joshbohm37/Flip-segment-clock/README.md

# Flip Segment Clock
A desktop clock centered around electromechanical 7 segment flip displays.
