joshbohm37/Flip-segment-clock/docs/design-notes/landing.md

# Subsystems

[Control Logic](control-logic.md)

[Flip Segment Drivers](segment-driver.md)

[Power Notes](power-notes.md)

[Wifi Integration](wifi-integration.md)

[Lessons Learned](lessons-learned.md)
