joshbohm37/Flip-segment-clock/docs/subsystems/landing.md

# Subsystems

[Control Logic](control-logic.md)

[Firmware](firmware.md)

[Flip Segment Drivers](flip-segments.md)

[Power Architecture](power-architecture.md)

[Wifi](wifi.md)
