joshbohm37/Flip-segment-clock/hardware/segment-driver-a3909/pcb/zips/LIB_A3909GLNTR-T/A3909GLNTR-T/3D/A3909GLNTR-T.stp

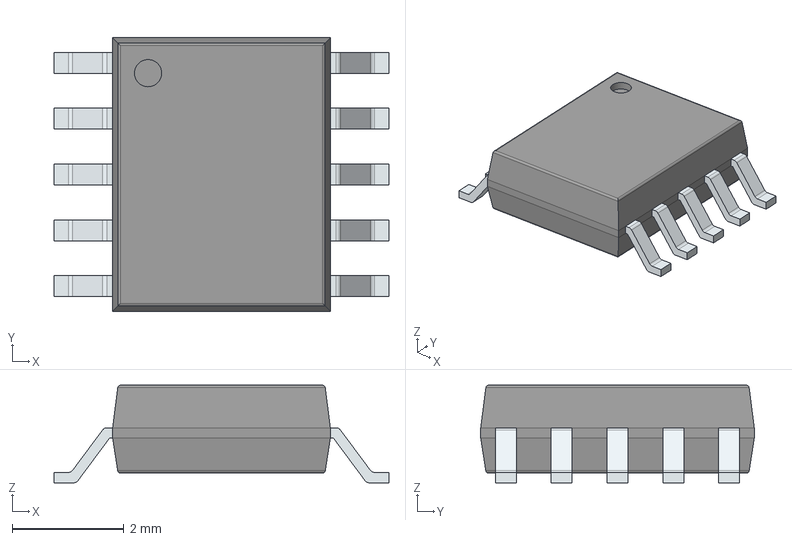
[picture p1: CAD file, 2025-11-30]
hardware/segment-driver-a3909/pcb/zips/LIB_A3909GLNTR-T/A3909GLNTR-T/3D/A3909GLNTR-T.stp
6.00 x 4.90 x 1.75 mm
PinsArrayLR
