joshbohm37/Flip-segment-clock/hardware/segment-driver-a3909/pcb/zips/LM73606RNPR/3D/LM73606RNPR.stp

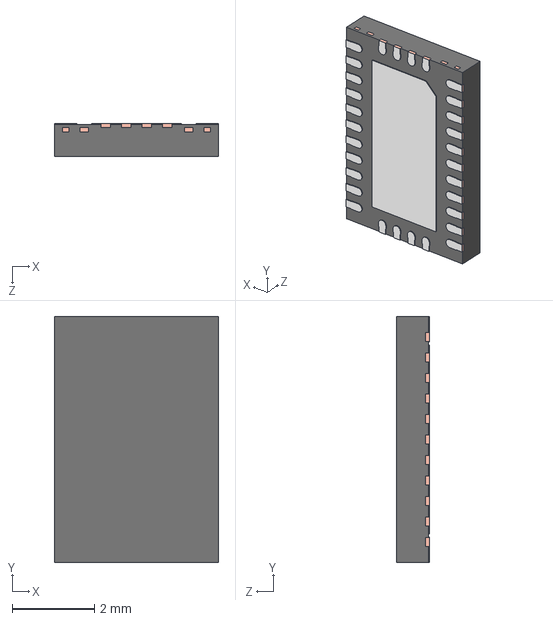
[picture p2: CAD file, 2025-11-30]
hardware/segment-driver-a3909/pcb/zips/LM73606RNPR/3D/LM73606RNPR.stp
4.00 x 6.00 x 0.8 mm
BODY-QFN
FRAME
