joshbohm37/Flip-segment-clock/(list of files, cad)

Other CAD files:
hardware/segment-driver-a3909/pcb/zips/LIB_A3909GLNTR-T/A3909GLNTR-T/Allegro/sop100p600x175-10n.psm
hardware/segment-driver-a3909/pcb/zips/LIB_A3909GLNTR-T/A3909GLNTR-T/DEHDL/a3909glntr_t/chips/chips.prt
hardware/segment-driver-a3909/pcb/zips/LM73606RNPR/Allegro/rnp0030a.psm
hardware/segment-driver-a3909/pcb/zips/LM73606RNPR/DEHDL/lm73606rnpr/chips/chips.prt
