joshbohm37/Flip-segment-clock/docs/changelog.md

#Changelog

**needs updating for all changes prior to 2026**

**1/1/26**: Refining design of the segment drivers

**1/3/26**: Implementation of per digit gating on A3909 clusters, allowing for isolation of power during time updates.
