joshbohm37/Flip-segment-clock/hardware/segment-driver-a3909/schematics/Sch.pdf

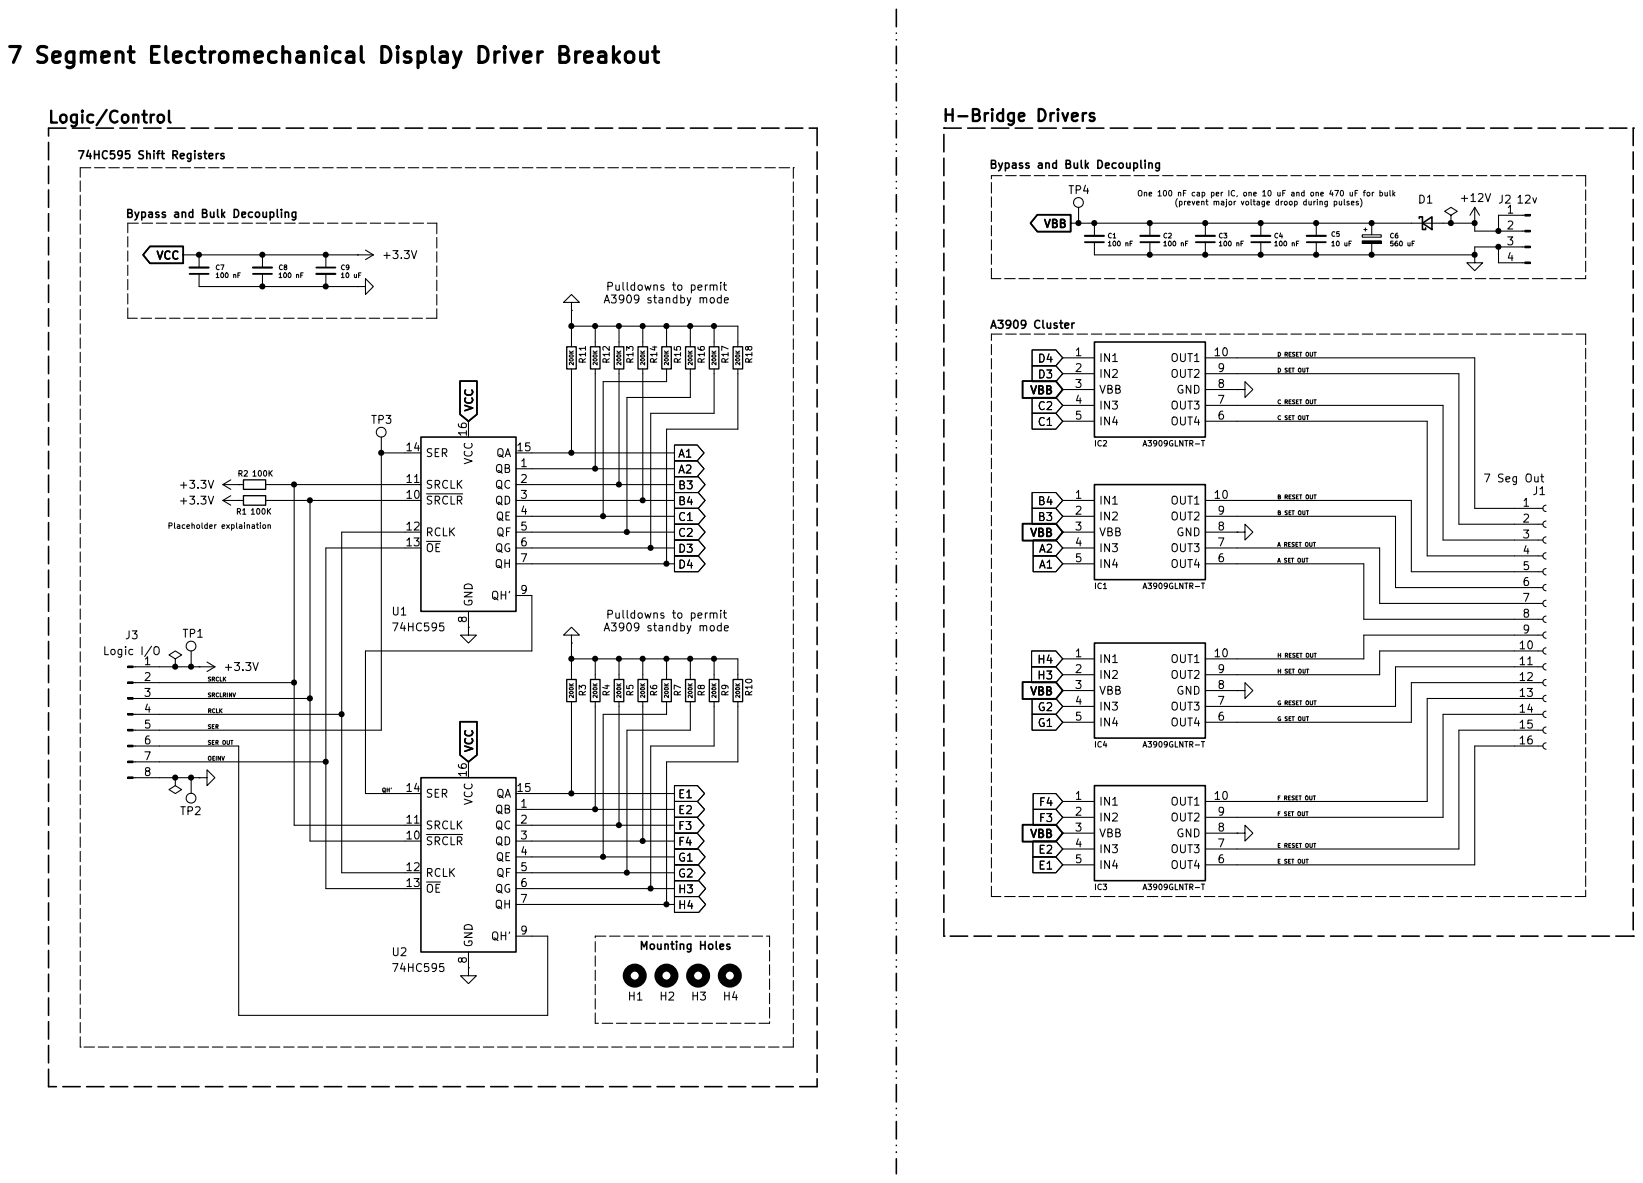
[picture p3: page 1]
