joshbohm37/Flip-segment-clock/(list of files, drawings)

Other design files:
hardware/segment-driver-a3909/pcb/zips/LIB_A3909GLNTR-T/A3909GLNTR-T/Altium/A3909GLNTR-T.SchLib
hardware/segment-driver-a3909/pcb/zips/LIB_A3909GLNTR-T/A3909GLNTR-T/Altium/SOP100P600X175-10N.PcbLib
