joshbohm37/Flip-segment-clock/hardware/main-board/pcb/flip-segment-clock_main-board/flip-segment-clock_main-board.kicad_pcb

## KiCad design hardware/main-board/pcb/flip-segment-clock_main-board/flip-segment-clock_main-board.kicad_pcb (2026-01-03)

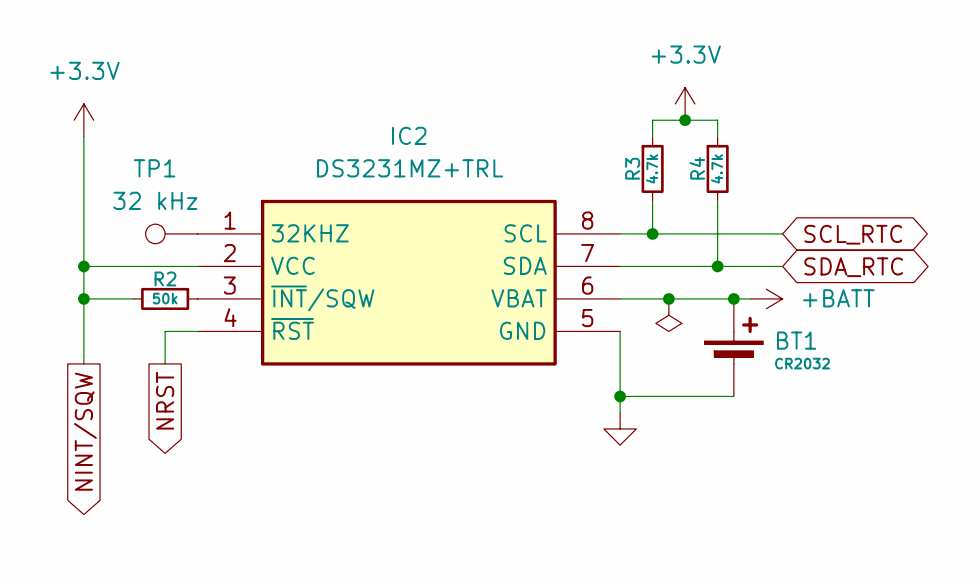
[picture p9: schematic DS3231.kicad_sch]

Parts:
BT1: CR2032; BatteryHolder_Keystone_1057_1x2032
IC2: DS3231MZ+TRL; SOIC127P600X175-8N; Mouser Part Number 700-DS3231MZ+TRL
R2: 50k; R_0402_1005Metric
R3, R4: 4.7k; R_0402_1005Metric
TP1: 32 kHz; TestPoint_Pad_D2.5mm

Connections:
+BATT: BT1.1 (+), IC2.6 (VBAT); also elsewhere on the board
GND: BT1.2 (-), IC2.5 (GND); also elsewhere on the board
NINT/SQW: IC2.2 (VCC), R2.2, R3.1, R4.1; also elsewhere on the board
NRST: IC2.4 (~RST)
unnamed: IC2.1 (32KHZ), TP1.1
unnamed: IC2.3 (~INT/SQW), R2.1
SCL_RTC: IC2.8 (SCL), R3.2
SDA_RTC: IC2.7 (SDA), R4.2

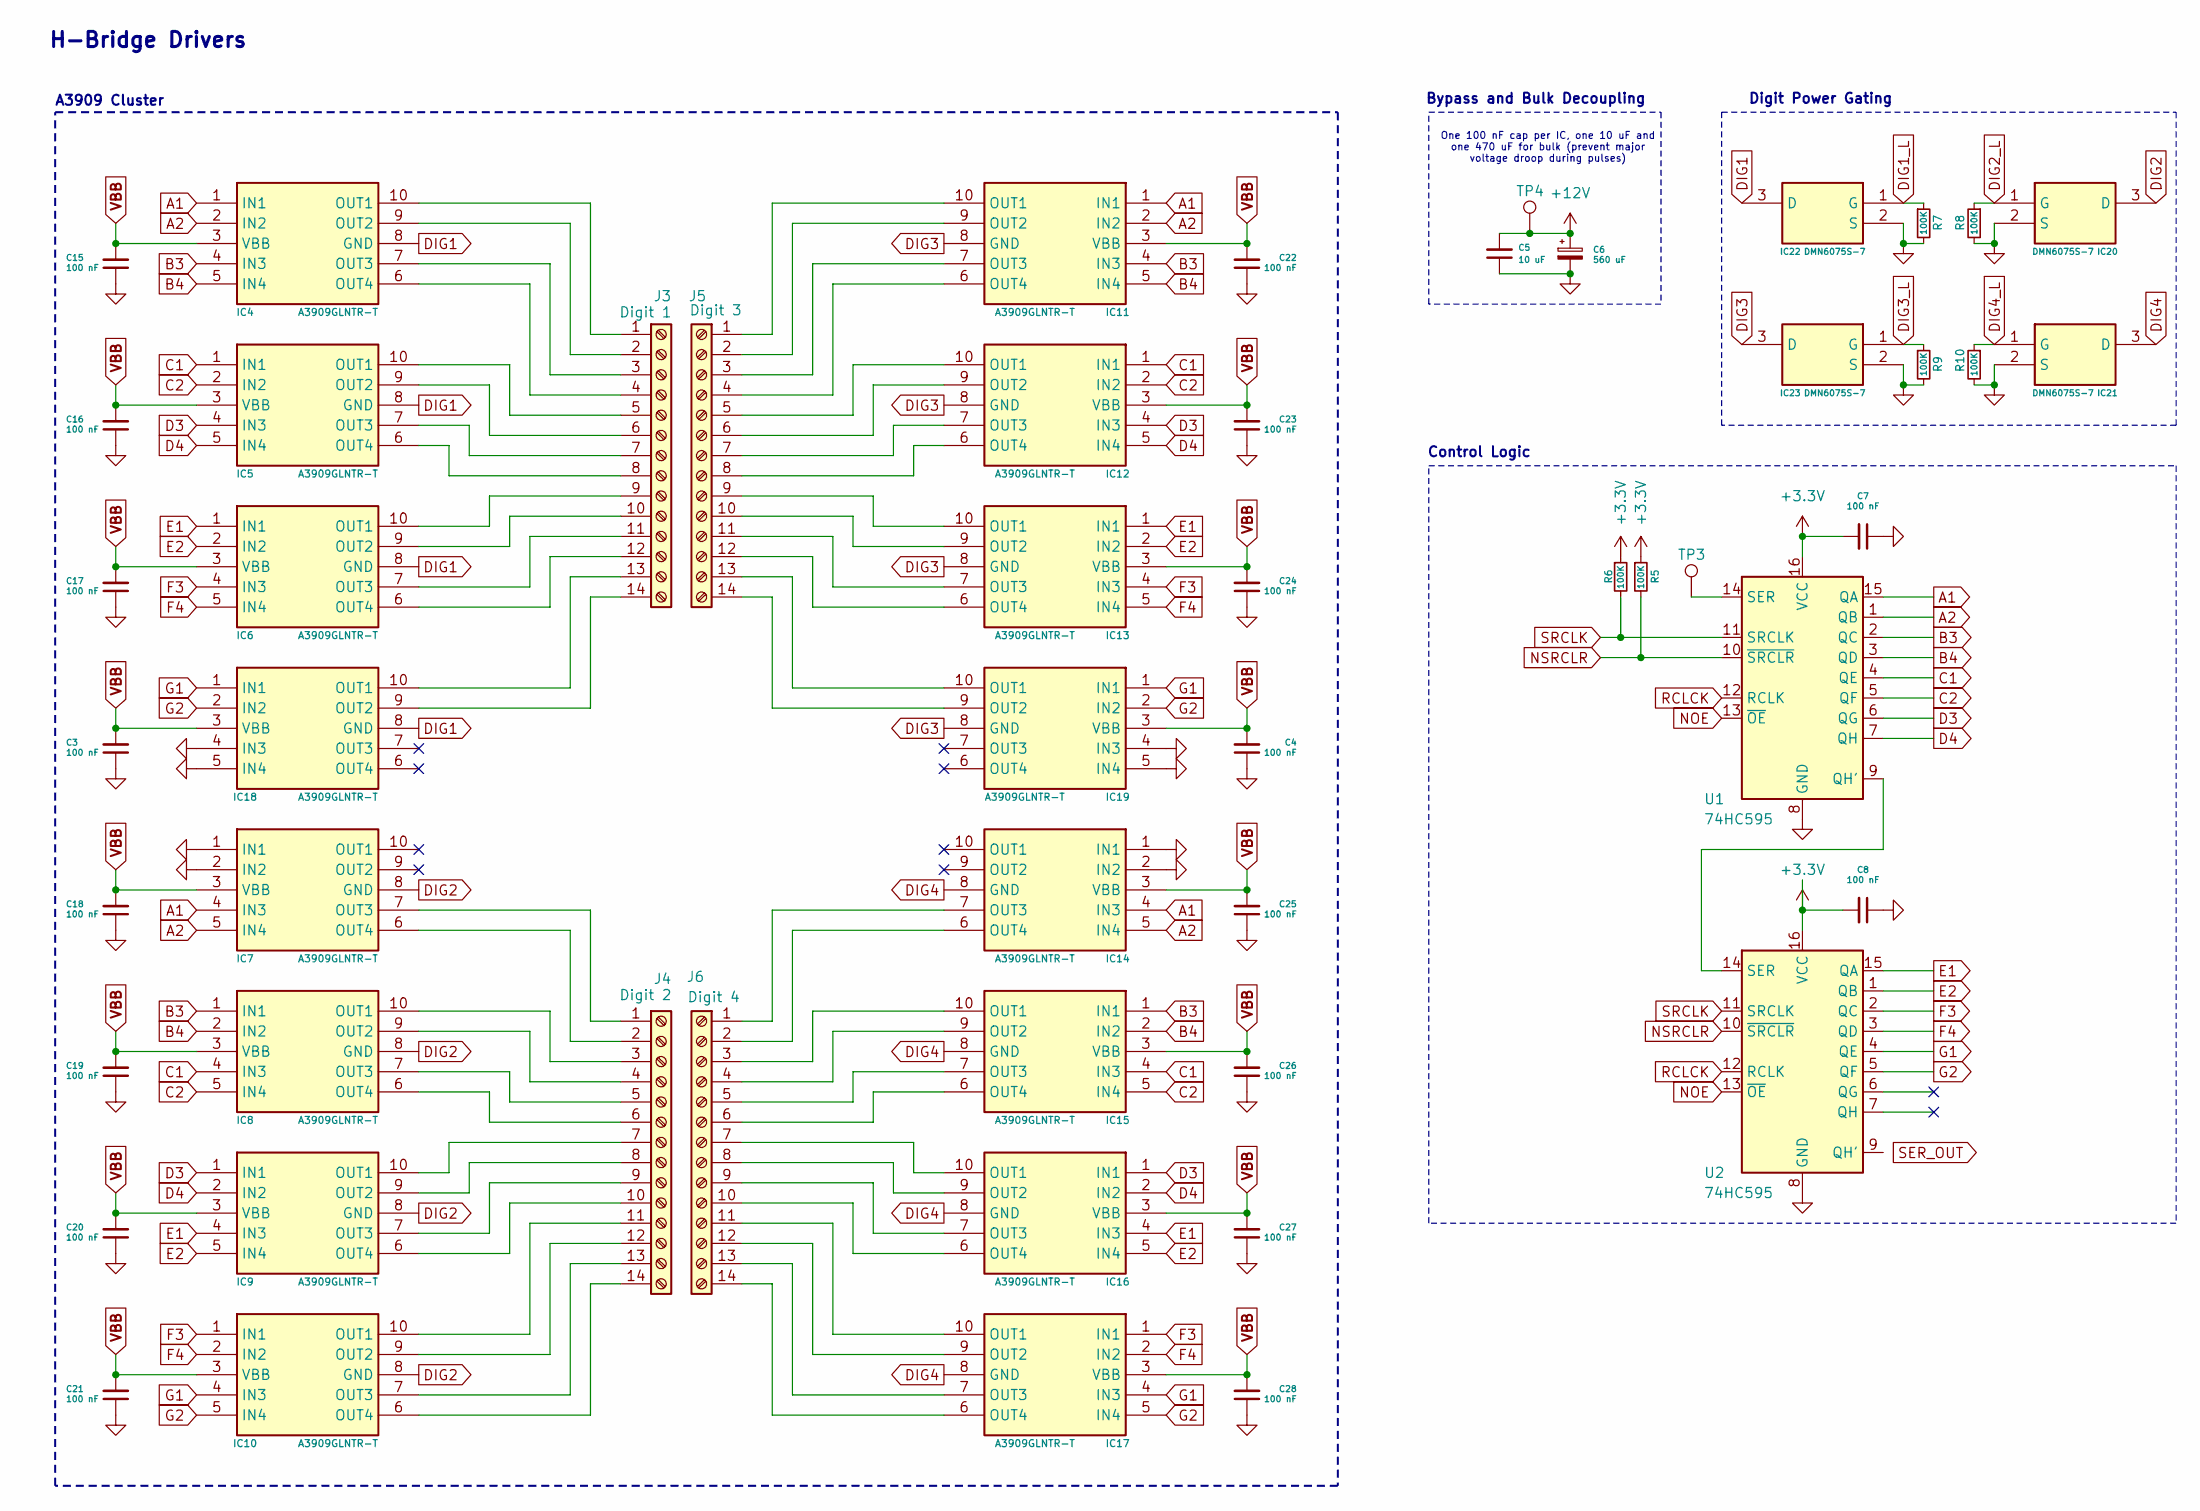
[picture p10: schematic segment-drivers.kicad_sch]

Parts:
C3, C4, C7, C8, C15, C16, C17, C18, C19, C20, C21, C22, C23, C24, C25, C26, C27, C28: 100 nF; C_0402_1005Metric; Manufacturer part # CL05B104KA5NNNC; LCSC C155422
C5: 10 uF; C_1206_3216Metric; Manufacturer part # CL31A106KAHNNNE; LCSC C9807
C6: 560 uF; C_Elec_10x10.2; Manufacturer part # EMZR350ARA561MJA0G; LCSC C2163314
IC4, IC5, IC6, IC7, IC8, IC9, IC10, IC11, IC12, IC13, IC14, IC15, IC16, IC17, IC18, IC19: A3909GLNTR-T; SOP100P600X175-10N; Mouser Part Number 250-A3909GLNTR-T
IC20, IC21, IC22, IC23: DMN6075S-7; SOT96P240X110-3N; Mouser Part Number 621-DMN6075S-7
J3: Digit 1; TerminalBlock_Xinya_XY308-2.54-14P_1x14_P2.54mm_Horizontal
J4: Digit 2; TerminalBlock_Xinya_XY308-2.54-14P_1x14_P2.54mm_Horizontal
J5: Digit 3; TerminalBlock_Xinya_XY308-2.54-14P_1x14_P2.54mm_Horizontal
J6: Digit 4; TerminalBlock_Xinya_XY308-2.54-14P_1x14_P2.54mm_Horizontal
R5, R6: 100K; R_0402_1005Metric; Manufacturer part # 0402WGF1003TCE; LCSC C25741
R7, R8, R9, R10: 100K; R_0402_1005Metric
TP3: SER; TestPoint_Pad_D1.5mm
TP4: 12v; TestPoint_Pad_D1.5mm
U1, U2: 74HC595; SOIC-16_3.9x9.9mm_P1.27mm; Manufacturer part # 74HC595D,118; LCSC C5947

Connections:
+12V: C5.2, C6.1, TP4.1; also elsewhere on the board
A1: IC4.1 (IN1), IC7.4 (IN3), IC11.1 (IN1), IC14.4 (IN3), U1.15 (QA)
A2: IC4.2 (IN2), IC7.5 (IN4), IC11.2 (IN2), IC14.5 (IN4), U1.1 (QB)
B3: IC4.4 (IN3), IC8.1 (IN1), IC11.4 (IN3), IC15.1 (IN1), U1.2 (QC)
B4: IC4.5 (IN4), IC8.2 (IN2), IC11.5 (IN4), IC15.2 (IN2), U1.3 (QD)
C1: IC5.1 (IN1), IC8.4 (IN3), IC12.1 (IN1), IC15.4 (IN3), U1.4 (QE)
C2: IC5.2 (IN2), IC8.5 (IN4), IC12.2 (IN2), IC15.5 (IN4), U1.5 (QF)
D3: IC5.4 (IN3), IC9.1 (IN1), IC12.4 (IN3), IC16.1 (IN1), U1.6 (QG)
D4: IC5.5 (IN4), IC9.2 (IN2), IC12.5 (IN4), IC16.2 (IN2), U1.7 (QH)
DIG1: IC4.8 (GND), IC5.8 (GND), IC6.8 (GND), IC18.8 (GND), IC22.3 (D)
DIG1_L: IC22.1 (G), R7.1
DIG2: IC7.8 (GND), IC8.8 (GND), IC9.8 (GND), IC10.8 (GND), IC20.3 (D)
DIG2_L: IC20.1 (G), R8.1
DIG3: IC11.8 (GND), IC12.8 (GND), IC13.8 (GND), IC19.8 (GND), IC23.3 (D)
DIG3_L: IC23.1 (G), R9.1
DIG4: IC14.8 (GND), IC15.8 (GND), IC16.8 (GND), IC17.8 (GND), IC21.3 (D)
DIG4_L: IC21.1 (G), R10.1
E1: IC6.1 (IN1), IC9.4 (IN3), IC13.1 (IN1), IC16.4 (IN3), U2.15 (QA)
E2: IC6.2 (IN2), IC9.5 (IN4), IC13.2 (IN2), IC16.5 (IN4), U2.1 (QB)
F3: IC6.4 (IN3), IC10.1 (IN1), IC13.4 (IN3), IC17.1 (IN1), U2.2 (QC)
F4: IC6.5 (IN4), IC10.2 (IN2), IC13.5 (IN4), IC17.2 (IN2), U2.3 (QD)
G1: IC10.4 (IN3), IC17.4 (IN3), IC18.1 (IN1), IC19.1 (IN1), U2.4 (QE)
G2: IC10.5 (IN4), IC17.5 (IN4), IC18.2 (IN2), IC19.2 (IN2), U2.5 (QF)
GND: C3.1, C4.1, C5.1, C6.2, C7.1, C8.1, C15.1, C16.1, C17.1, C18.1, C19.1, C20.1, C21.1, C22.1, C23.1, C24.1, C25.1, C26.1, C27.1, C28.1, IC7.1 (IN1), IC7.2 (IN2), IC14.1 (IN1), IC14.2 (IN2), IC18.4 (IN3), IC18.5 (IN4), IC19.4 (IN3), IC19.5 (IN4), IC20.2 (S), IC21.2 (S), IC22.2 (S), IC23.2 (S), R7.2, R8.2, R9.2, R10.2, U1.8 (GND), U2.8 (GND); also elsewhere on the board
NINT/SQW: C7.2, C8.2, R5.1, R6.1, U1.16 (VCC), U2.16 (VCC); also elsewhere on the board
NOE: U1.13 (~OE), U2.13 (~OE)
NSRCLR: R5.2, U1.10 (~SRCLR), U2.10 (~SRCLR)
unnamed: IC4.10 (OUT1), J3.1
unnamed: IC4.9 (OUT2), J3.2
unnamed: IC4.7 (OUT3), J3.3
unnamed: IC4.6 (OUT4), J3.4
unnamed: IC5.10 (OUT1), J3.5
unnamed: IC5.9 (OUT2), J3.6
unnamed: IC5.7 (OUT3), J3.7
unnamed: IC5.6 (OUT4), J3.8
unnamed: IC6.10 (OUT1), J3.9
unnamed: IC6.9 (OUT2), J3.10
unnamed: IC6.7 (OUT3), J3.11
unnamed: IC6.6 (OUT4), J3.12
unnamed: IC7.7 (OUT3), J4.1
unnamed: IC7.6 (OUT4), J4.2
unnamed: IC8.10 (OUT1), J4.3
unnamed: IC8.9 (OUT2), J4.4
unnamed: IC8.7 (OUT3), J4.5
unnamed: IC8.6 (OUT4), J4.6
unnamed: IC9.10 (OUT1), J4.7
unnamed: IC9.9 (OUT2), J4.8
unnamed: IC9.7 (OUT3), J4.9
unnamed: IC9.6 (OUT4), J4.10
unnamed: IC10.10 (OUT1), J4.11
unnamed: IC10.9 (OUT2), J4.12
unnamed: IC10.7 (OUT3), J4.13
unnamed: IC10.6 (OUT4), J4.14
unnamed: IC11.10 (OUT1), J5.1
unnamed: IC11.9 (OUT2), J5.2
unnamed: IC11.7 (OUT3), J5.3
unnamed: IC11.6 (OUT4), J5.4
unnamed: IC12.10 (OUT1), J5.5
unnamed: IC12.9 (OUT2), J5.6
unnamed: IC12.7 (OUT3), J5.7
unnamed: IC12.6 (OUT4), J5.8
unnamed: IC13.10 (OUT1), J5.9
unnamed: IC13.9 (OUT2), J5.10
unnamed: IC13.7 (OUT3), J5.11
unnamed: IC13.6 (OUT4), J5.12
unnamed: IC14.7 (OUT3), J6.1
unnamed: IC14.6 (OUT4), J6.2
unnamed: IC15.10 (OUT1), J6.3
unnamed: IC15.9 (OUT2), J6.4
unnamed: IC15.7 (OUT3), J6.5
unnamed: IC15.6 (OUT4), J6.6
unnamed: IC16.10 (OUT1), J6.7
unnamed: IC16.9 (OUT2), J6.8
unnamed: IC16.7 (OUT3), J6.9
unnamed: IC16.6 (OUT4), J6.10
unnamed: IC17.10 (OUT1), J6.11
unnamed: IC17.9 (OUT2), J6.12
unnamed: IC17.7 (OUT3), J6.13
unnamed: IC17.6 (OUT4), J6.14
unnamed: IC18.10 (OUT1), J3.13
unnamed: IC18.9 (OUT2), J3.14
unnamed: IC19.10 (OUT1), J5.13
unnamed: IC19.9 (OUT2), J5.14
unnamed: U1.9 (QH'), U2.14 (SER)
unnamed: TP3.1, U1.14 (SER)
RCLCK: U1.12 (RCLK), U2.12 (RCLK)
SRCLK: R6.2, U1.11 (SRCLK), U2.11 (SRCLK)
VBB: C3.2, C4.2, C15.2, C16.2, C17.2, C18.2, C19.2, C20.2, C21.2, C22.2, C23.2, C24.2, C25.2, C26.2, C27.2, C28.2, IC4.3 (VBB), IC5.3 (VBB), IC6.3 (VBB), IC7.3 (VBB), IC8.3 (VBB), IC9.3 (VBB), IC10.3 (VBB), IC11.3 (VBB), IC12.3 (VBB), IC13.3 (VBB), IC14.3 (VBB), IC15.3 (VBB), IC16.3 (VBB), IC17.3 (VBB), IC18.3 (VBB), IC19.3 (VBB)

Notes on the sheet:
Control Logic
H-Bridge Drivers
Digit Power Gating
Bypass and Bulk Decoupling
One 100 nF cap per IC, one 10 uF and one 470 uF for bulk (prevent major voltage droop during pulses)
A3909 Cluster

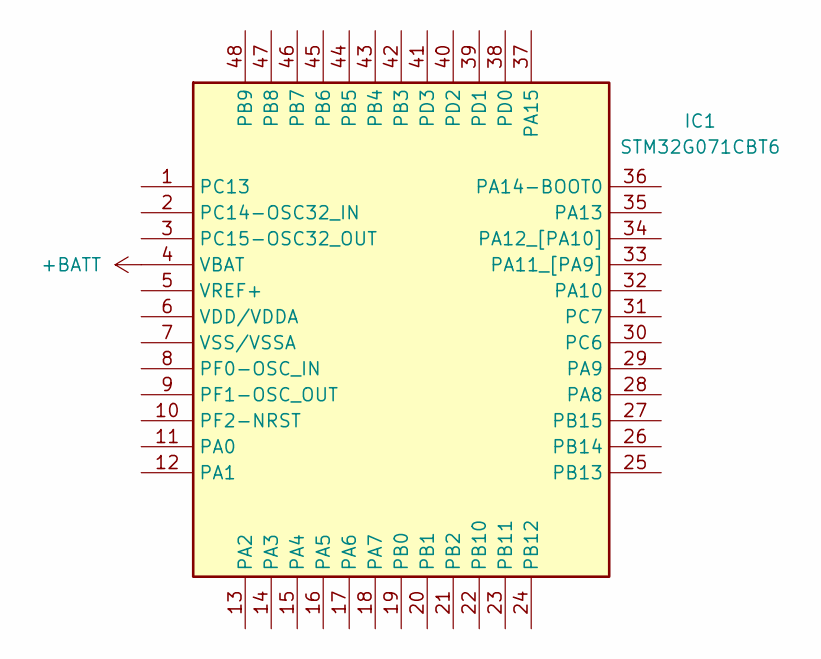
[picture p11: schematic STM32G071CBT6.kicad_sch]

Parts:
IC1: STM32G071CBT6; QFP50P900X900X160-48N; Mouser Part Number 511-STM32G071CBT6

Connections:
+BATT: IC1.4 (VBAT); also elsewhere on the board

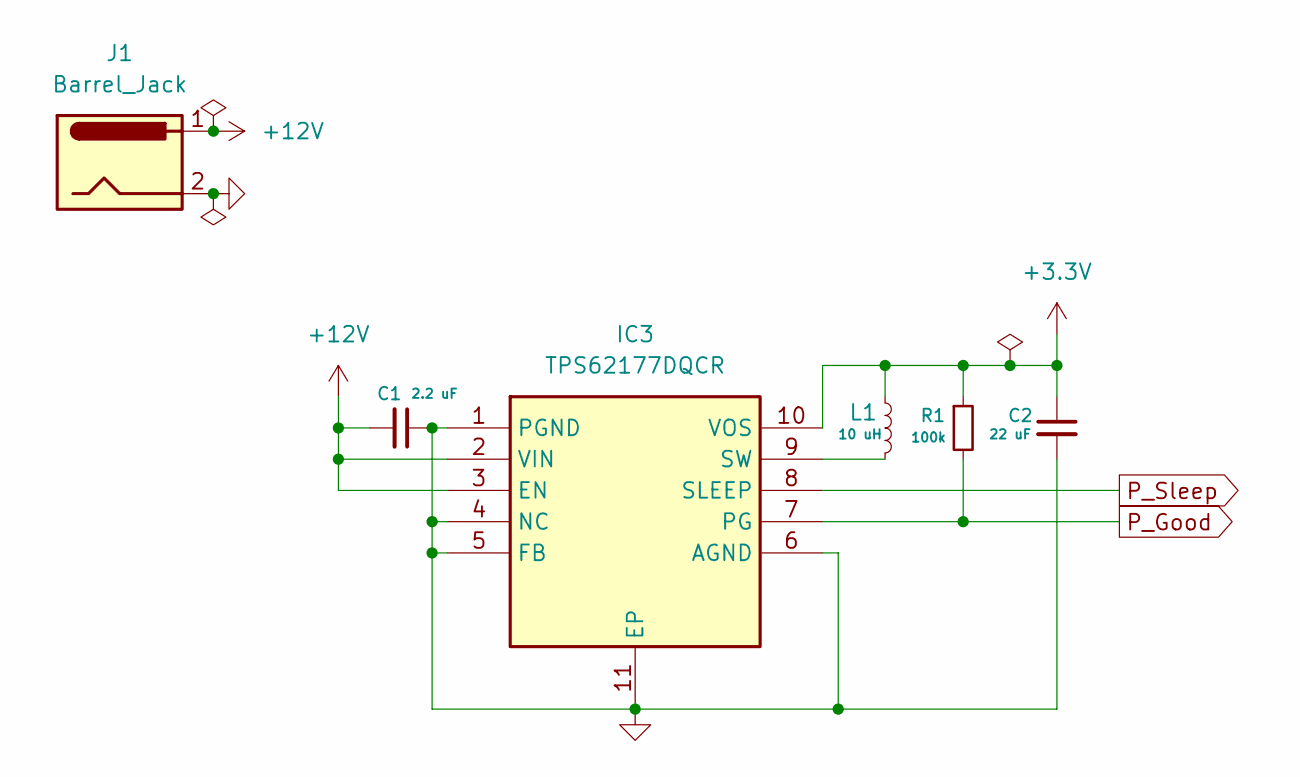
[picture p12: schematic power.kicad_sch]

Parts:
C1: 2.2 uF; C_0402_1005Metric
C2: 22 uF; C_0402_1005Metric
IC3: TPS62177DQCR; SON50P200X300X80-11N; Mouser Part Number 595-TPS62177DQCR
J1: Barrel_Jack; BarrelJack_SwitchcraftConxall_RAPC10U_Horizontal
L1: 10 uH; L_Coilcraft_LPS4018
R1: 100k; R_0402_1005Metric

Connections:
+12V: C1.2, IC3.2 (VIN), IC3.3 (EN), J1.1; also elsewhere on the board
GND: C1.1, C2.2, IC3.1 (PGND), IC3.4 (NC), IC3.5 (FB), IC3.6 (AGND), IC3.11 (EP), J1.2; also elsewhere on the board
NINT/SQW: C2.1, IC3.10 (VOS), L1.1, R1.1; also elsewhere on the board
unnamed: IC3.9 (SW), L1.2
P_Good: IC3.7 (PG), R1.2
P_Sleep: IC3.8 (SLEEP)

Board: 2 copper layers, 67 parts (0 on the bottom side), 95 nets, no tracks yet.
