joshbohm37/Flip-segment-clock/hardware/segment-driver-a3909/pcb/A3909 Prototyping.kicad_pcb

## KiCad design hardware/segment-driver-a3909/pcb/A3909 Prototyping.kicad_pcb (2025-12-24)

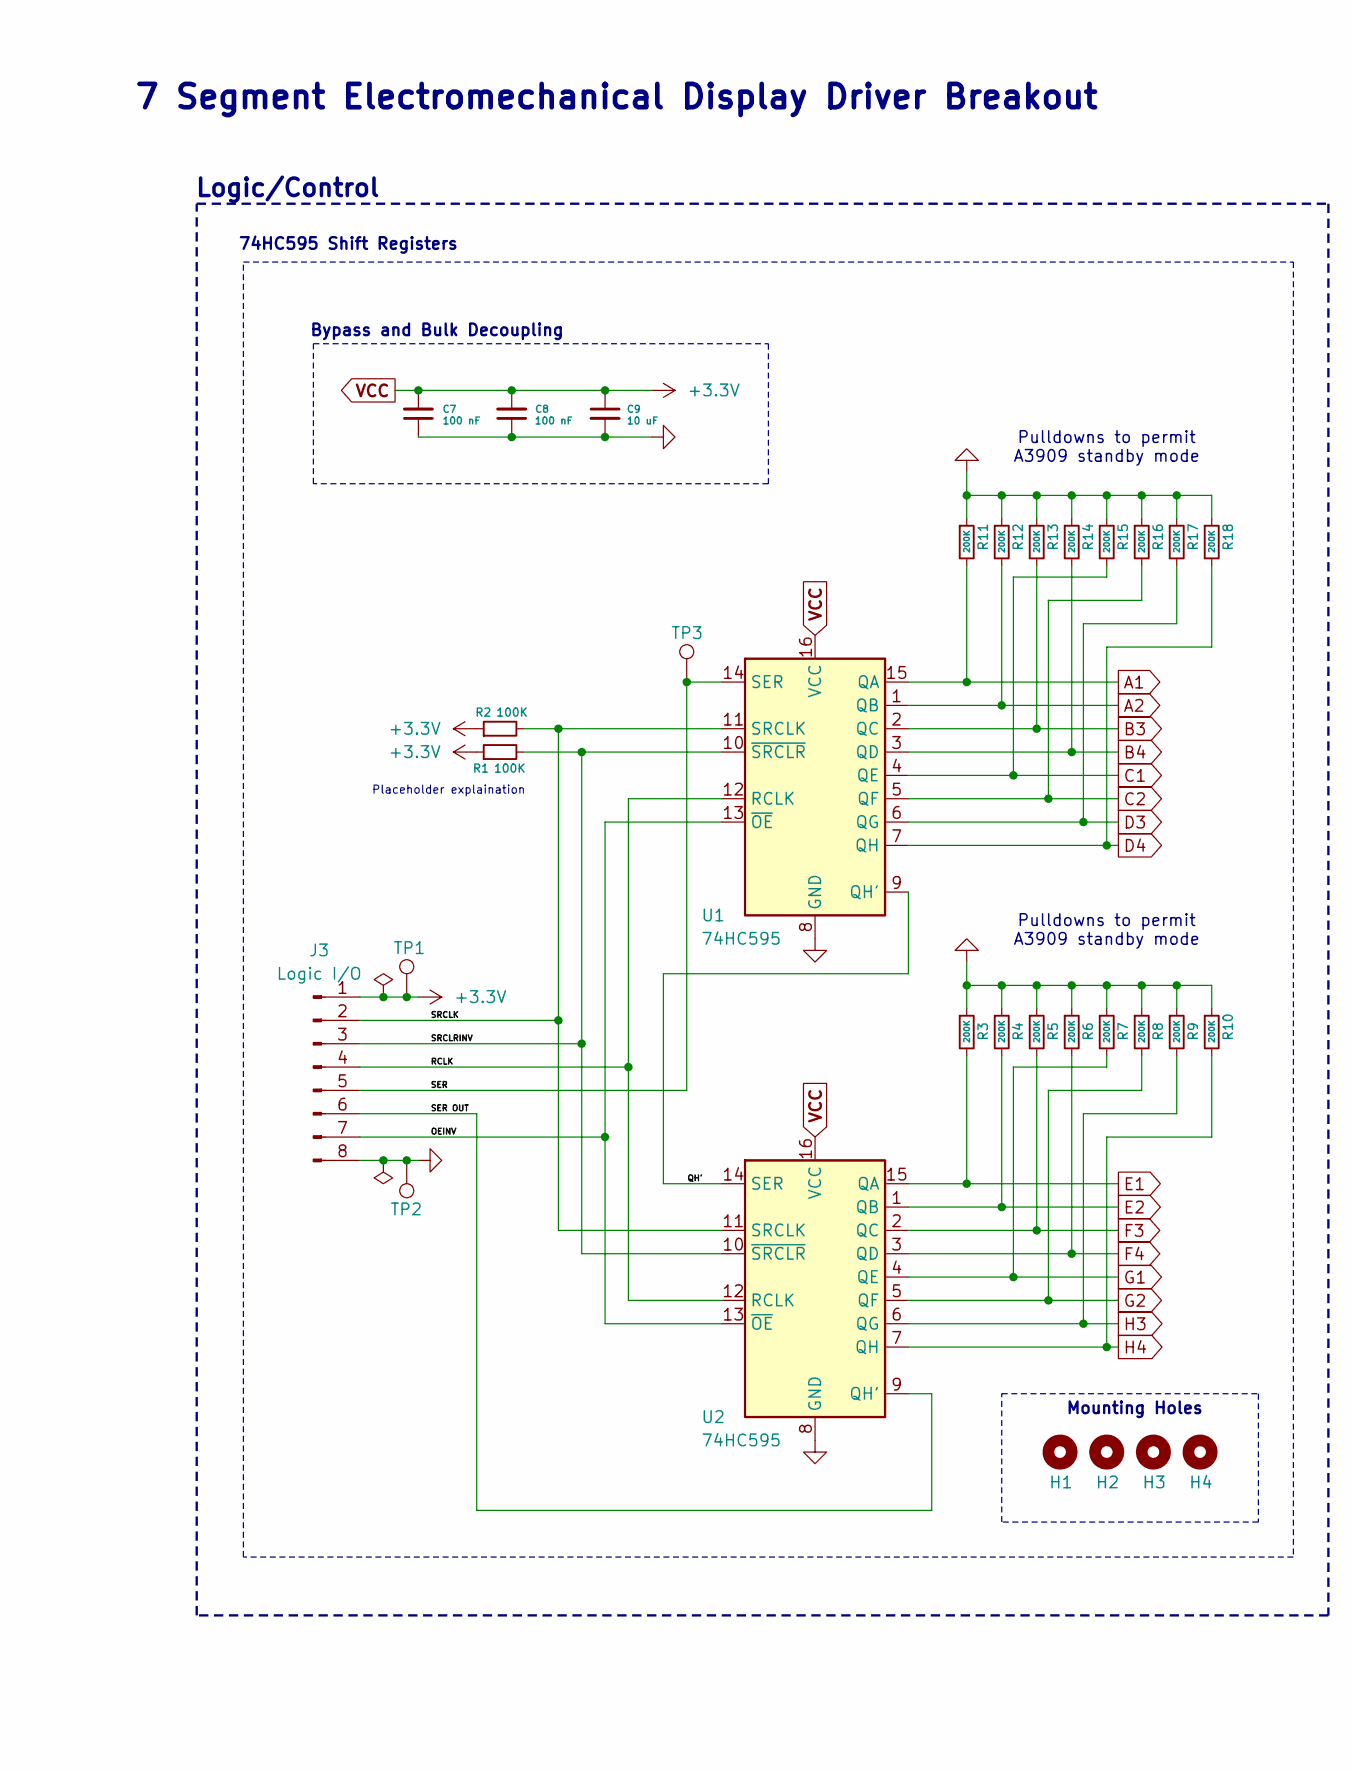
[picture p13: schematic A3909 Prototyping.kicad_sch, part in row 1, column 1]

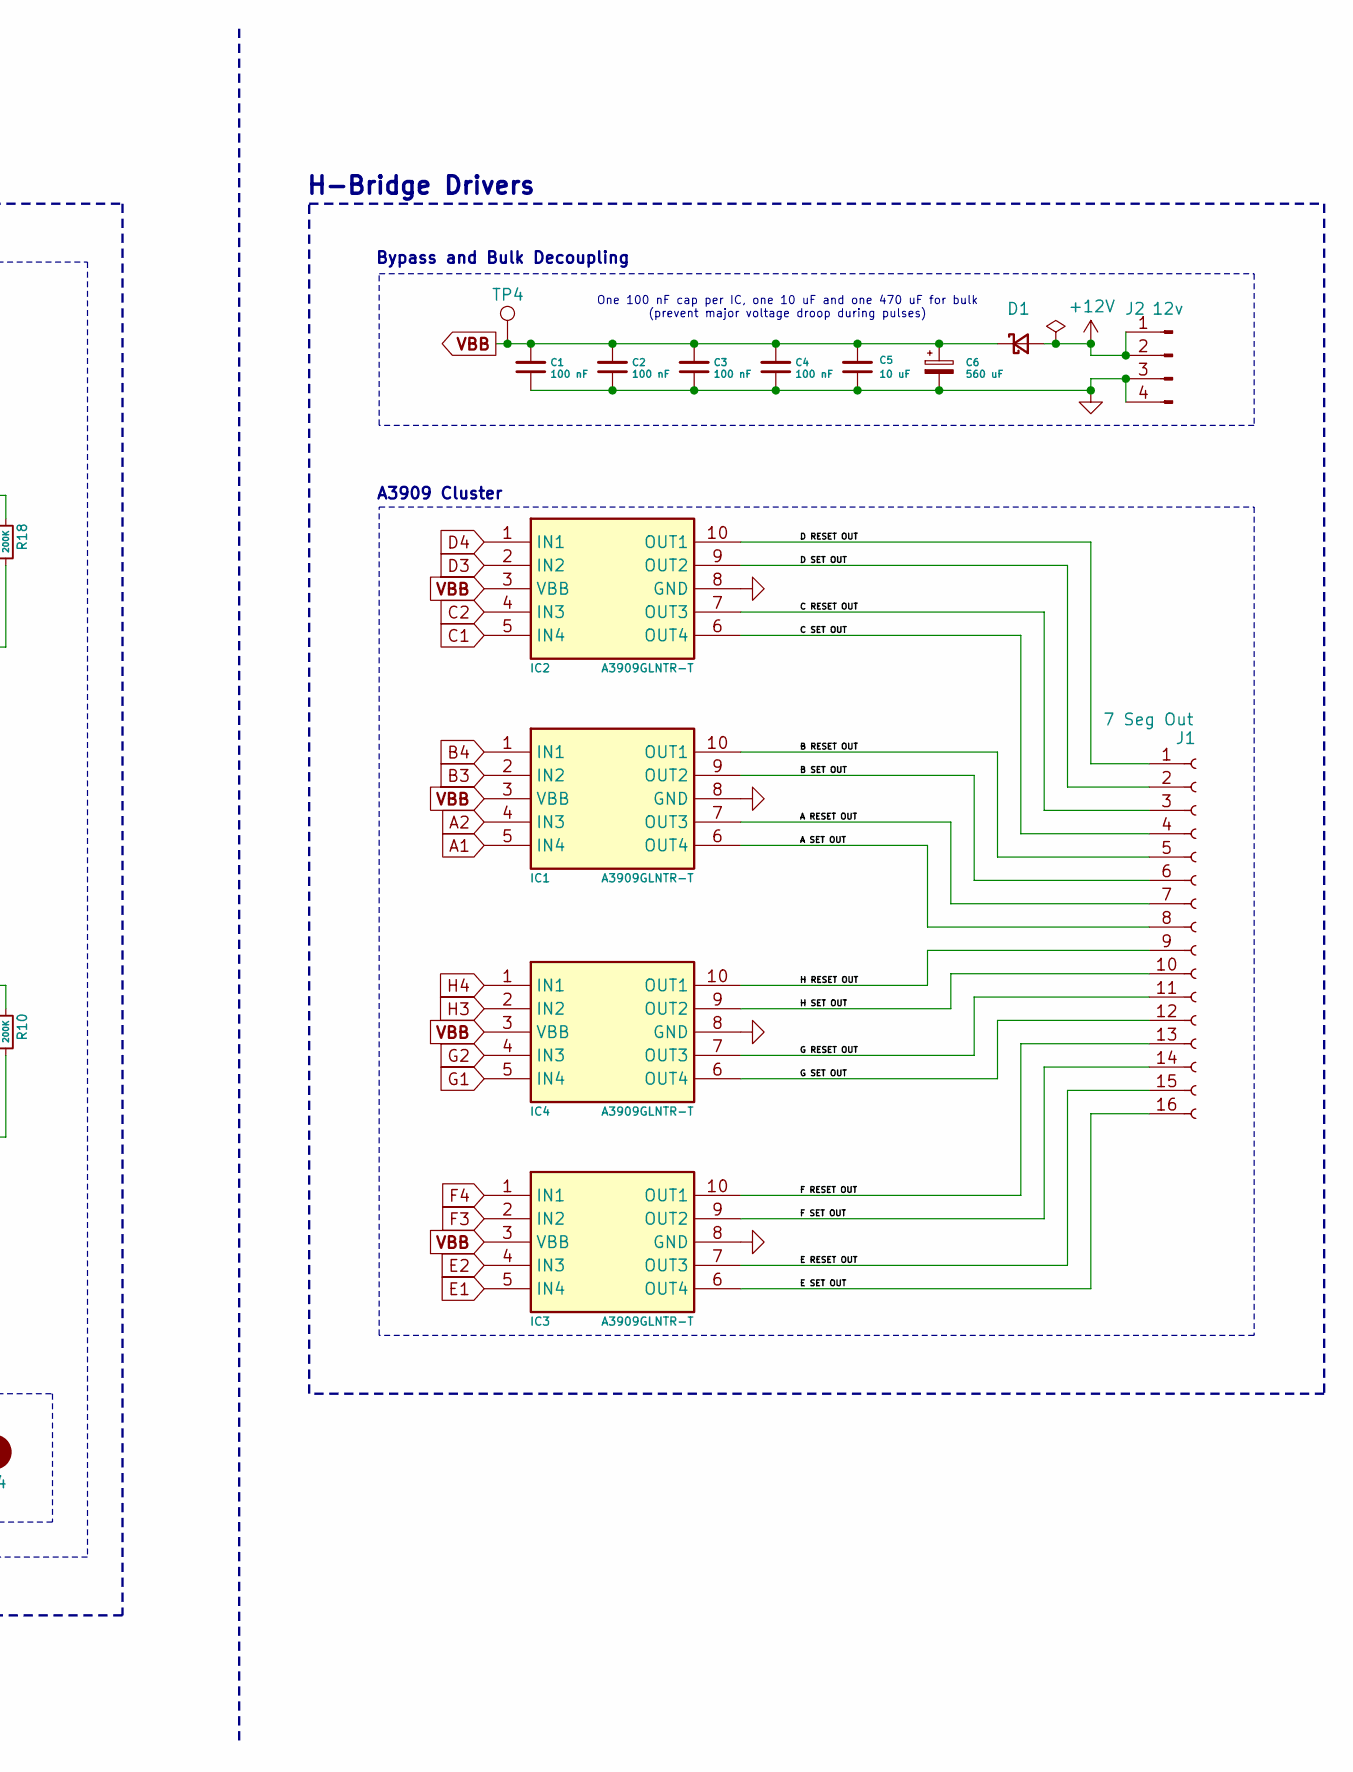
[picture p14: schematic A3909 Prototyping.kicad_sch, part in row 1, column 2]

Parts:
C1, C2, C3, C4, C7, C8: 100 nF; C_0402_1005Metric; Manufacturer part # CL05B104KA5NNNC; LCSC C155422
C5, C9: 10 uF; C_1206_3216Metric; Manufacturer part # CL31A106KAHNNNE; LCSC C9807
C6: 560 uF; C_Elec_10x10.2; Manufacturer part # EMZR350ARA561MJA0G; LCSC C2163314
D1: D_Schottky_Small; D_SMB; Manufacturer part # SS54B; LCSC C32513
H1, H2, H3, H4: MountingHole; MountingHole_2.2mm_M2
IC1, IC2, IC3, IC4: A3909GLNTR-T; SOP100P600X175-10N; Mouser Part Number 250-A3909GLNTR-T
J1: 7 Seg Out; PinHeader_1x16_P2.54mm_Vertical; Manufacturer part # DS1021-1x16SF11-B; LCSC C7430372
J2: 12v; PinHeader_1x04_P2.54mm_Vertical; Manufacturer part # KH-2.54PH180-1X4P-L11.5; LCSC C2905435
J3: Logic I/O; PinHeader_1x08_P2.54mm_Vertical; Manufacturer part # KH-2.54PH180-1X8P-L11.5; LCSC C2905487
R1, R2: 100K; R_0402_1005Metric; Manufacturer part # 0402WGF1003TCE; LCSC C25741
R3, R4, R5, R6, R7, R8, R9, R10, R11, R12, R13, R14, R15, R16, R17, R18: 200K; R_0402_1005Metric; Manufacturer part # 0402WGF2003TCE; LCSC C25764
TP1: 3.3v; TestPoint_Pad_D1.5mm
TP2: GND; TestPoint_Pad_D1.5mm
TP3: SER; TestPoint_Pad_D1.5mm
TP4: 12v; TestPoint_Pad_D1.5mm
U1, U2: 74HC595; SOIC-16_3.9x9.9mm_P1.27mm; Manufacturer part # 74HC595D,118; LCSC C5947

Connections:
+12V: D1.2 (A), J2.1, J2.2
/A RESET OUT: IC1.7 (OUT3), J1.7
/A SET OUT: IC1.6 (OUT4), J1.8
/B RESET OUT: IC1.10 (OUT1), J1.5
/B SET OUT: IC1.9 (OUT2), J1.6
/C RESET OUT: IC2.7 (OUT3), J1.3
/C SET OUT: IC2.6 (OUT4), J1.4
/D RESET OUT: IC2.10 (OUT1), J1.1
/D SET OUT: IC2.9 (OUT2), J1.2
/E RESET OUT: IC3.7 (OUT3), J1.15
/E SET OUT: IC3.6 (OUT4), J1.16
/F RESET OUT: IC3.10 (OUT1), J1.13
/F SET OUT: IC3.9 (OUT2), J1.14
/G RESET OUT: IC4.7 (OUT3), J1.11
/G SET OUT: IC4.6 (OUT4), J1.12
/H RESET OUT: IC4.10 (OUT1), J1.9
/H SET OUT: IC4.9 (OUT2), J1.10
/OEINV: J3.7, U1.13 (~OE), U2.13 (~OE)
/QH': U1.9 (QH'), U2.14 (SER)
/RCLK: J3.4, U1.12 (RCLK), U2.12 (RCLK)
/SER: J3.5, TP3.1, U1.14 (SER)
/SER OUT: J3.6, U2.9 (QH')
/SRCLK: J3.2, R2.2, U1.11 (SRCLK), U2.11 (SRCLK)
/SRCLRINV: J3.3, R1.2, U1.10 (~SRCLR), U2.10 (~SRCLR)
A1: IC1.5 (IN4), R11.2, U1.15 (QA)
A2: IC1.4 (IN3), R12.2, U1.1 (QB)
B3: IC1.2 (IN2), R13.2, U1.2 (QC)
B4: IC1.1 (IN1), R14.2, U1.3 (QD)
C1: IC2.5 (IN4), R15.2, U1.4 (QE)
C2: IC2.4 (IN3), R16.2, U1.5 (QF)
D3: IC2.2 (IN2), R17.2, U1.6 (QG)
D4: IC2.1 (IN1), R18.2, U1.7 (QH)
E1: IC3.5 (IN4), R3.2, U2.15 (QA)
E2: IC3.4 (IN3), R4.2, U2.1 (QB)
F3: IC3.2 (IN2), R5.2, U2.2 (QC)
F4: IC3.1 (IN1), R6.2, U2.3 (QD)
G1: IC4.5 (IN4), R7.2, U2.4 (QE)
G2: IC4.4 (IN3), R8.2, U2.5 (QF)
GND: C1.1, C2.1, C3.1, C4.1, C5.1, C6.2, C7.1, C8.1, C9.2, IC1.8 (GND), IC2.8 (GND), IC3.8 (GND), IC4.8 (GND), J2.3, J2.4, J3.8, R3.1, R4.1, R5.1, R6.1, R7.1, R8.1, R9.1, R10.1, R11.1, R12.1, R13.1, R14.1, R15.1, R16.1, R17.1, R18.1, TP2.1, U1.8 (GND), U2.8 (GND)
H3: IC4.2 (IN2), R9.2, U2.6 (QG)
H4: IC4.1 (IN1), R10.2, U2.7 (QH)
VBB: C1.2, C2.2, C3.2, C4.2, C5.2, C6.1, D1.1 (K), IC1.3 (VBB), IC2.3 (VBB), IC3.3 (VBB), IC4.3 (VBB), TP4.1
VCC: C7.2, C8.2, C9.1, J3.1, R1.1, R2.1, TP1.1, U1.16 (VCC), U2.16 (VCC)

Notes on the sheet:
Pulldowns to permit A3909 standby mode
74HC595 Shift Registers
A3909 Cluster
7 Segment Electromechanical Display Driver Breakout
Placeholder explaination
Bypass and Bulk Decoupling
One 100 nF cap per IC, one 10 uF and one 470 uF for bulk (prevent major voltage droop during pulses)
Logic/Control
Mounting Holes
H-Bridge Drivers

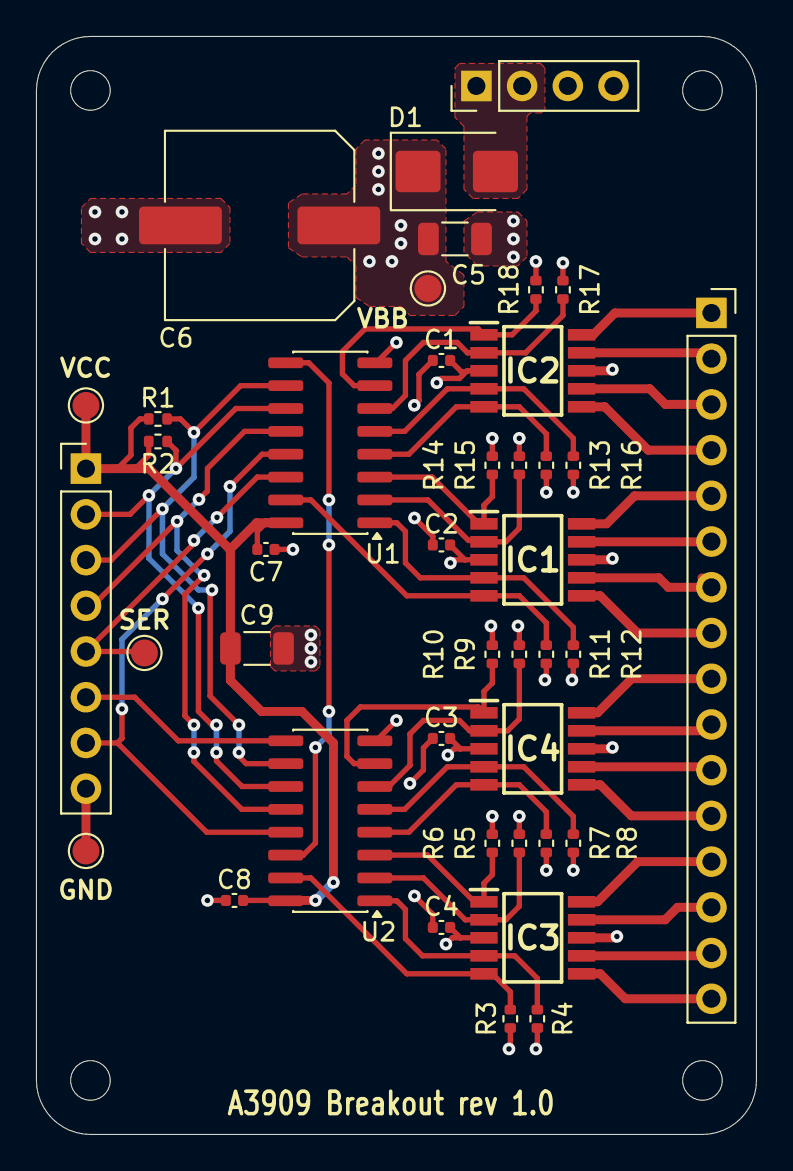
[picture p15: board A3909 Prototyping.kicad_pcb from above]

Board: 2 copper layers, 40.0 x 61.0 mm, 45 parts (0 on the bottom side), 43 nets.
