joshbohm37/Flip-segment-clock/firmware/stm32/flip-segment-clock_main-board/flip-segment-clock_main-board.ioc

Mcu.UserName=STM32G071CBTx
PA0.GPIO_Label=WIFI_SCK
PA0.Signal=SPI2_SCK
PA1.GPIO_Label=SR_SCK
PA1.Signal=SPI1_SCK
PA10.GPIO_Label=RTC_SDA
PA10.Signal=I2C1_SDA
PA2.GPIO_Label=SR_MOSI
PA2.Signal=SPI1_MOSI
PA3.GPIO_Label=WIFI_MISO
PA3.Signal=SPI2_MISO
PA4.GPIO_Label=WIFI_MOSI
PA4.Signal=SPI2_MOSI
PA9.GPIO_Label=RTC_SCL
PA9.Signal=I2C1_SCL
