joshbohm37/Flip-segment-clock/(commit log)

2025-11-30 Pullup/pulldowns Footprints
    [A3909GLNTR-T.SchLib, A3909GLNTR-T.stp, Drivers.kicad_sch, EDI2CAP.CFG, LM73606RNPR.stp, Power Supply.kicad_sch, SOP100P600X175-10N.PcbLib, chips.prt]
2025-12-03 Fin drivers, start voltage reg
    [Drivers.kicad_sch, Power Supply.kicad_sch]
2025-12-24 Restructuring of project
    Scope of this project exceeded the scope of the previous structure. Revamped the file structure to accommodate the entire flip segment clock project.
    -main folder now contains subfolders for each division of the project.
    -hardware folder now contains a subdirectory for each board that will be produced for the project.
    -created a docs folder to house github pages files.
    [A3909 Prototyping-B_Cu.gbl, A3909 Prototyping-B_Mask.gbs, A3909 Prototyping-B_Paste.gbp, A3909 Prototyping-B_Silkscreen.gbo, A3909 Prototyping-Edge_Cuts.gm1, A3909 Prototyping-F_Cu.gtl, A3909 Prototyping-F_Mask.gts, A3909 Prototyping-F_Paste.gtp]
2025-12-31 Documentation restructuring
    Added external documentation vs internal/design decision pages. setup github pages.
    [DS3231.kicad_sch, STM32G071CBT6.kicad_sch, flip-segment-clock_main-board.kicad_sch, power.kicad_sch, segment-drivers.kicad_sch]
2025-12-31 Update index.md
    Create a main landing page for the pages website. Documentation of my documentation.
2025-12-31 DRC file addition
    [flip-segment-clock_main-board.kicad_pcb]
2026-01-02 Refining design of the segment drivers
    [DS3231.kicad_sch, STM32G071CBT6.kicad_sch, flip-segment-clock_main-board.kicad_pcb, power.kicad_sch, segment-drivers.kicad_sch]
2026-01-03 Segment driver update
    Continuing refinement of segment driver design, settle on per digit vbb isolation, no overlapping between a3909
    [flip-segment-clock_main-board.kicad_pcb, segment-drivers.kicad_sch]
2026-01-03 Finalizing design of digit VBB isolation
    [flip-segment-clock_main-board.kicad_pcb, segment-drivers.kicad_sch]
2026-01-03 Changelog/design notes for Segment Drivers
    [flip-segment-clock_main-board.kicad_pcb, segment-drivers.kicad_sch]
2026-01-26 Unsure
    Unsure of previous changes due to time off. Currently edited the lessons learned page.
    [DS3231.kicad_sch, power.kicad_sch, segment-drivers.kicad_sch]
2026-01-27 CubeMX setup
    Started a new cubemx project for the stm32 on the main board. Mainly enabled/labeled connectivity.
